Fri3dCamp/blaster_2024/Hardware/Fri3d_2024_Blaster_00/OUTPUT/BOM/Bill of Materials-Fri3d_2024_Blaster_00(Default).xls

Bill of Materials |  |  | Fri3D 2024 Blaster
Project: |  | Fri3d_2024_Blaster_00.PrjPcb
Revision: |  | 00
Variant: |  | Default
Creation Date: | 16/04/2024 | 21:35
Print Date: | 2024-04-28 | 21:45:25
Footprint | Comment | LibRef | Designator | Value | Description | Supplier 1 | Supplier Part Number 1 | Supplier 2 | Supplier Part Number 2 | Supplier 3 | Supplier Part Number 3 | Quantity
CUI_CEP-1162 | 14x14x7mm Piezo Buzzer Transducer 80dB | BUZ CUI CEP-1162 | BUZ1 | CMT-1203-SMT | BUZ CUI CEP-1162 | Digi-key | 102-1134-ND | LCSC | C360604 |  |  | 1
C_8x9_3.5mm |  | CAP 47µF 50V 8X9 | C1 | 47µF 50V | CAP 47µF 50V 8X9 | LCSC | C270004 |  |  |  | 47µF 50V 1% _8x9 | 1
C_5.08mm |  | CAP 100nF 50V 5.08mm | C2, C3, C4 | 100nF 50V | CAP 100nF 50V 5.08mm | LCSC | C84772 |  |  |  |  | 3
LED_5MM_RD | 5mm IR LED, 940nm, 100mA, 1.35V, 25Deg | LED IR 5mm TSAL6400 | D1 | TSAL6400 | LED IR 5mm TSAL6400 | Farnell | 3152868 | LCSC | C264290 |  |  | 1
VIS_TSOP381x_BENT | IRM-3638N3F14 Infrared Receiver 38 kHz 45° 2.7-5.5V | PHO IR Rx RA | D3, D4 | IRM-3638N3F14 | PHO IR Rx RA | LCSC | C264262 |  |  |  |  | 2
LED_8mm_RGB_RA | WS2812 based digital RGB LED 85mm | LED RGB WS2812 8mm | D5, D6, D7, D8 | WS2812D-F8 | LED RGB WS2812 8mm | LCSC | C139126 |  |  |  |  | 4
CUI_SJ1-3525NG | 3.5mm jack, dual switch, black, 3 contacts | AUDIO JACK 3.5 3c SJ1-3525NG | J1 | SJ1-3525NG | AUDIO JACK 3.5 3c SJ1-3525NG | Digi-key | CP1-3525NG-ND |  |  |  |  | 1
PHYX_LANA_TNY_SMD | CH23V203 based TNY module | MOD # CH23V203 LANA TNY SMD | MOD1 | LANA TNY | MOD # CH23V203 LANA TNY SMD | Phyx | LANA TNY |  |  |  |  | 1
HDR1X2 | Header 2 | Pin Header 2.54mm 2way | P1, P4 |  | Pin Header 2.54mm 2way | LCSC | C492401 | LCSC | C541856 |  |  | 2
HDR1X7 | Header 7 | Pin Header 2.54mm 7way | P2, P3 |  | Pin Header 2.54mm 7way |  |  |  |  |  |  | 2
RES_10mm |  | RES 33R 1/4W | R1 | 33R | RES 33R 1/4W | LCSC | C173006 |  |  | Generic | 33R 1/4W 1% TH 10mm | 1
RES_10mm |  | RES 120R 1/4W | R2 | 120R | RES 120R 1/4W | LCSC | C58684 |  |  | Generic | 120R 1/4W 1% TH 10mm | 1
TACTSW_RA_385 | Tact switch, RA, 3,85mm | SW TACT RA 3,85mm 431256038716 | SW1 | 431256038716 | SW TACT RA 3,85mm 431256038716 | Wurth | 431256038716 | Mouser | 710-431256038716 |  |  | 1
SK13D07VG3 | 1P3T SK13D07VG3 3mm post | SW Slide SP3T SK13D07VG3 | SW2 | SK13D07VG3 | SW Slide SP3T SK13D07VG3 | LCSC | C2681580 |  |  |  |  | 1
TO-92A_WIDE | 0.2A 40V 100hfe NPN Transistor | 2N3904 NPN 0.2A | T1 | 2N3904 | 2N3904 NPN 0.2A | Farnell | 1700648 | LCSC | C118538 |  |  | 1
 |  |  |  |  |  |  |  |  |  |  |  | 23
Approved |  | Notes
