Fri3dCamp/blaster_2024/(threads)

Thread 1 (2024-05-02):

Replace current "CRC" by a real CRC8 implementation.

melazarus, 2024-05-02:
current CRC function is not a true CRC8.

Closed 2024-07-23.
