Fri3dCamp/blaster_2024/Hardware/Fri3d_2024_Blaster_01/OUTPUT/Fri3d_2024_Blaster_01.PDF

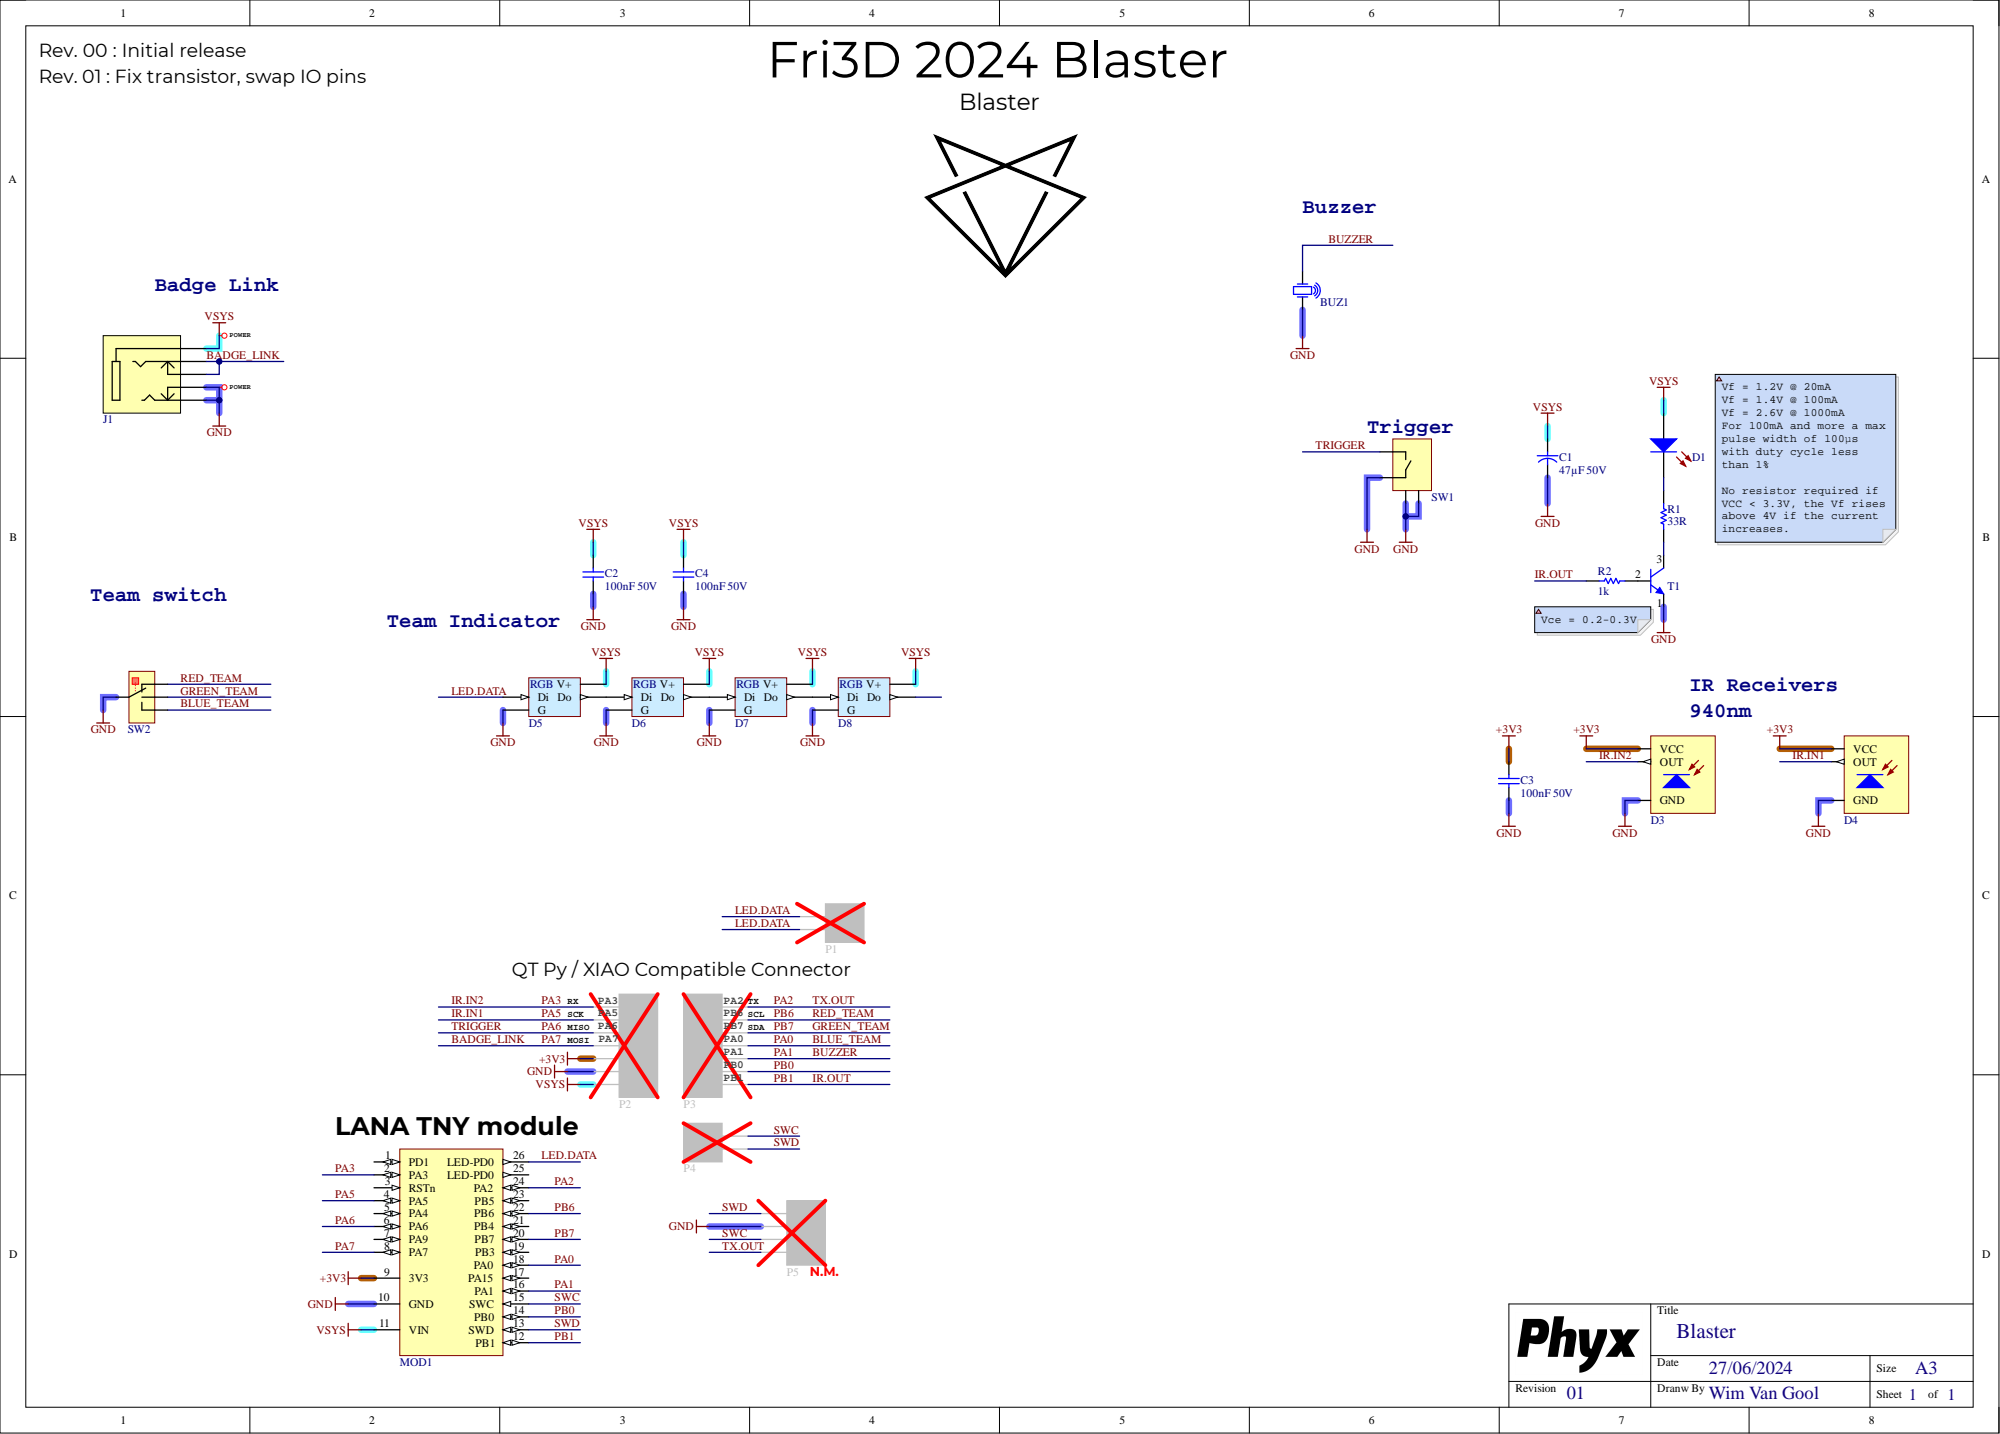
[picture p2: page 1]

Fri3D 2024 Blaster Rev. 00 : Initial release
Rev. 01 : Fix transis

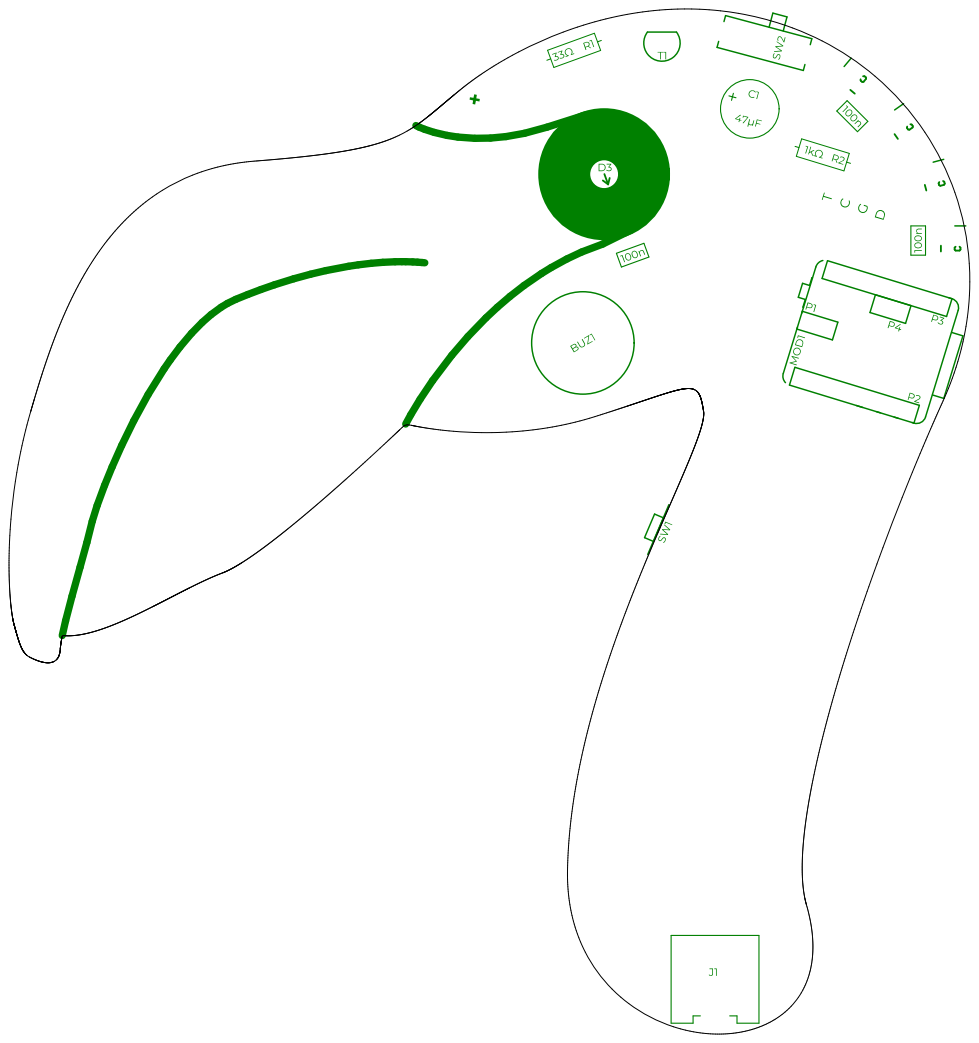
[picture p3: page 2]

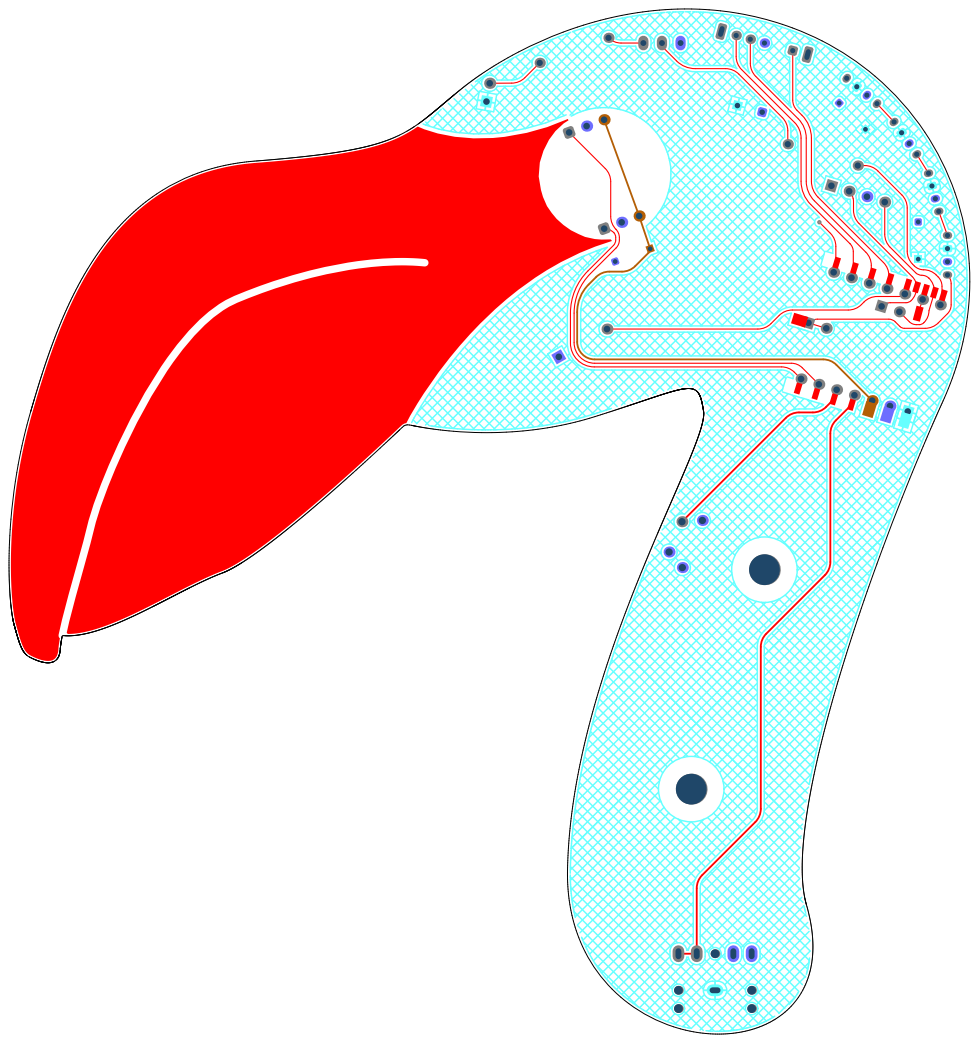
[picture p4: page 3]

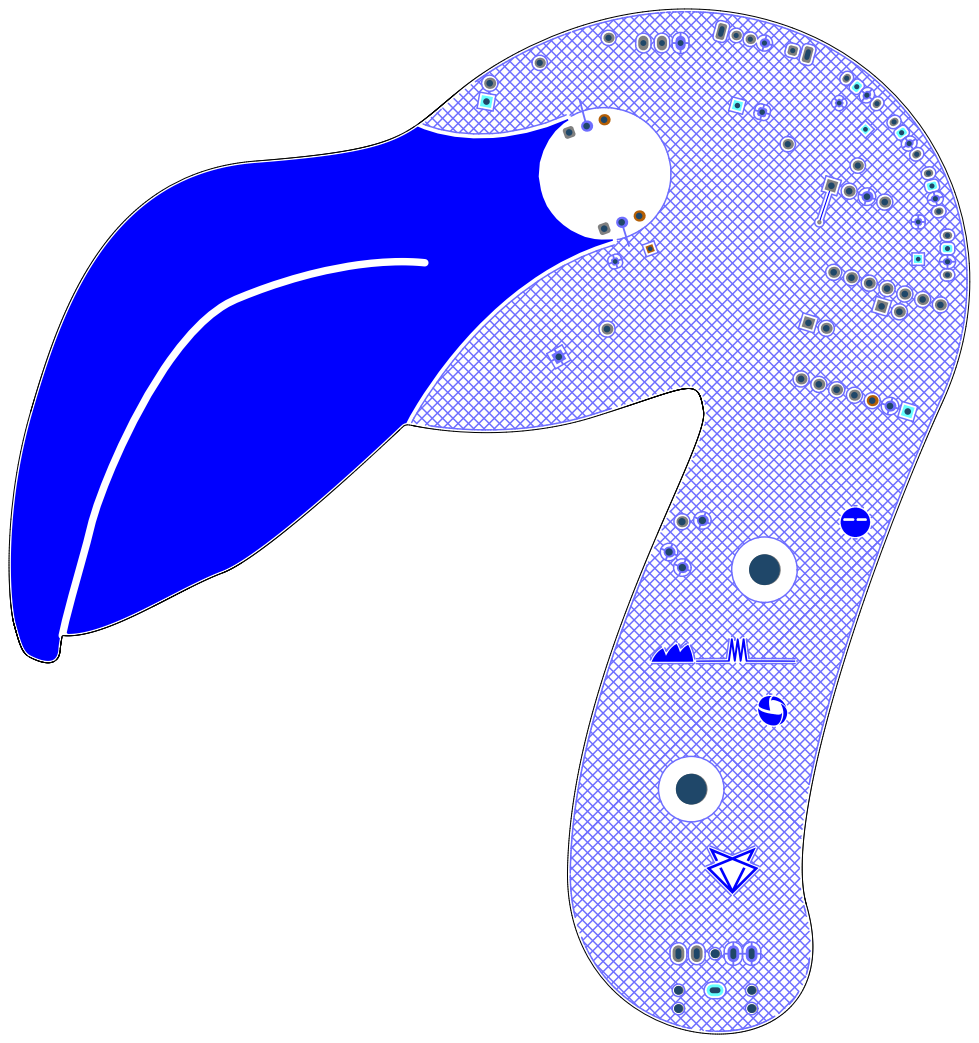
[picture p5: page 4]

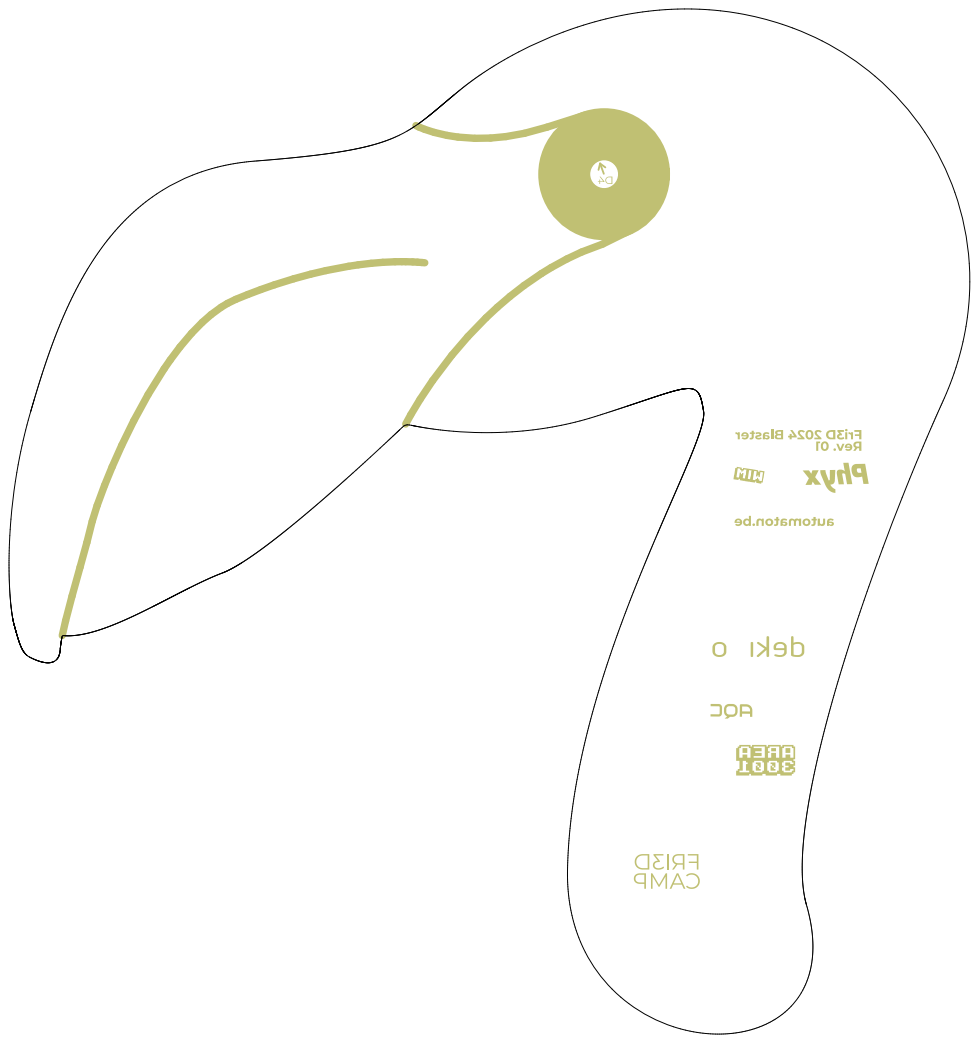
[picture p6: page 5]

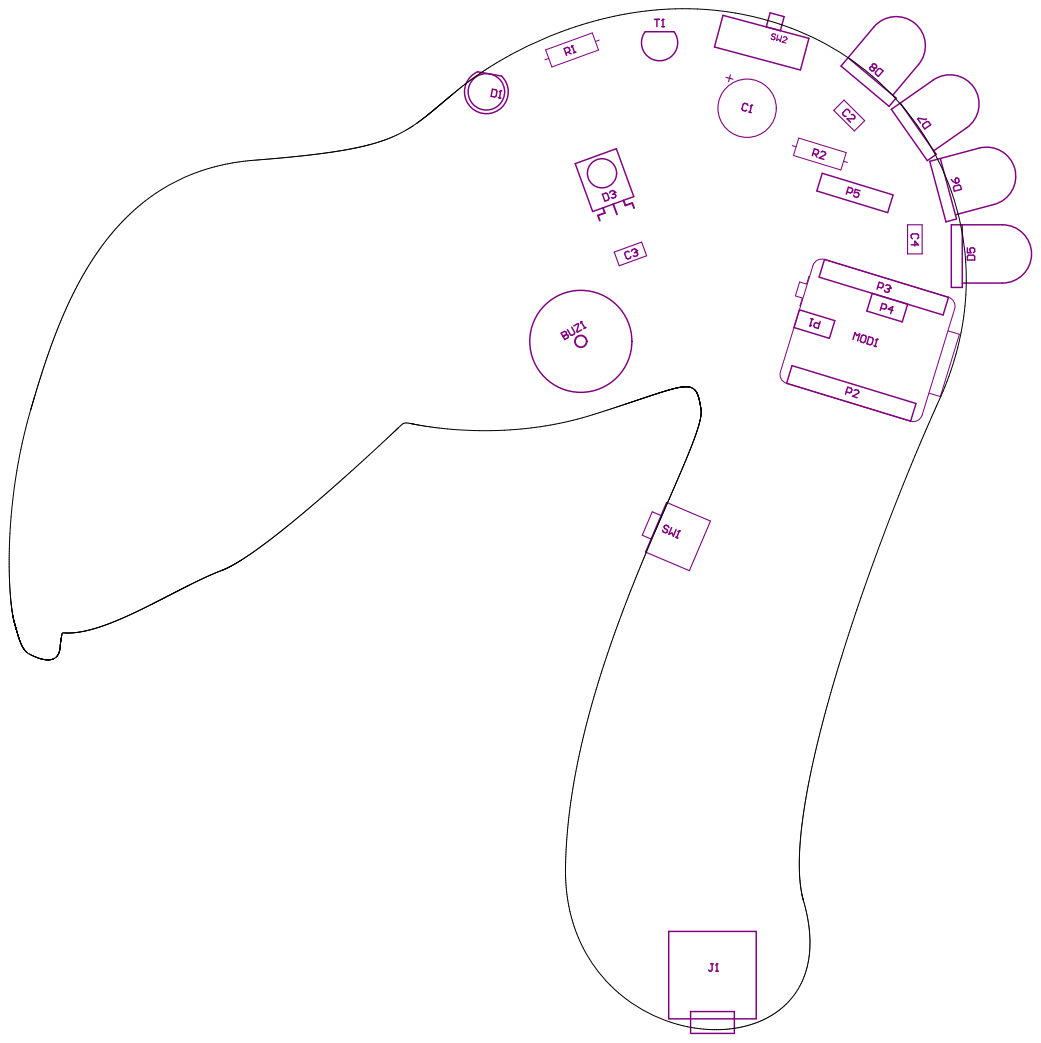
[picture p7: page 6]

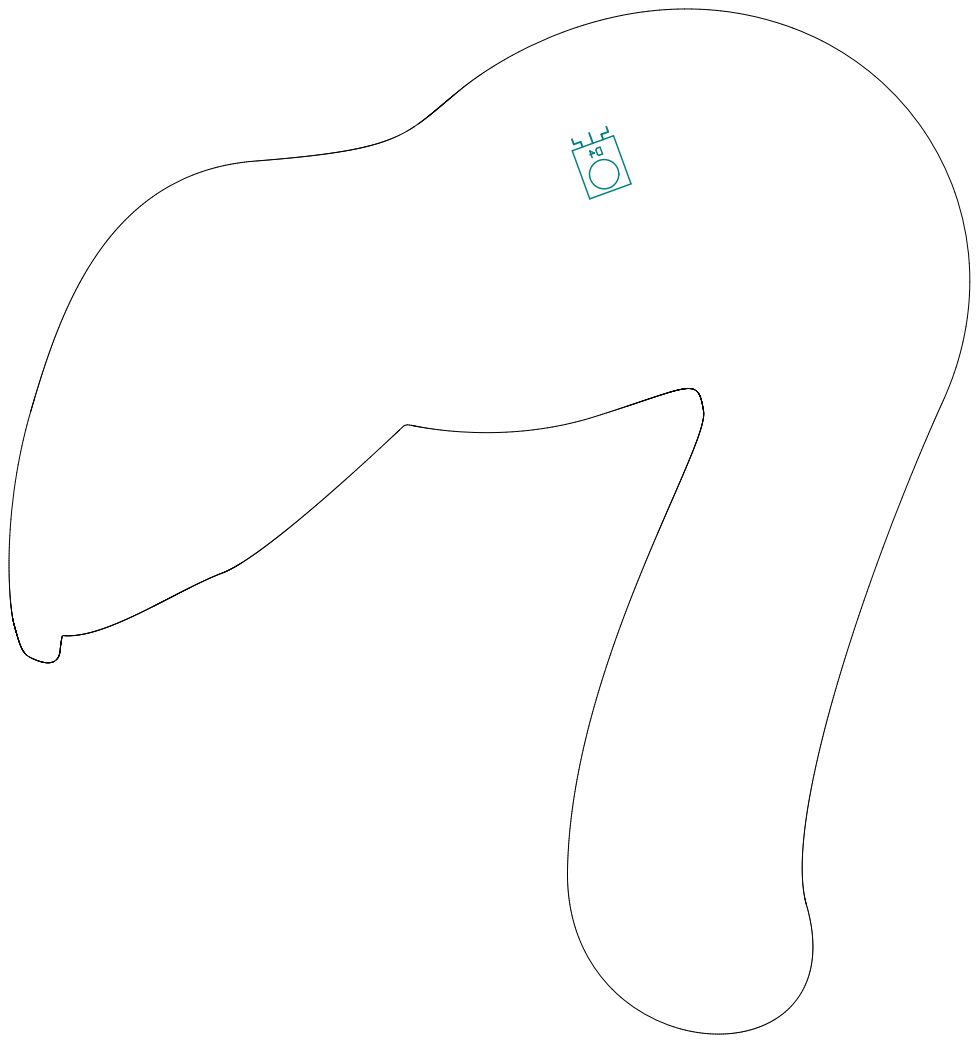
[picture p8: page 7]

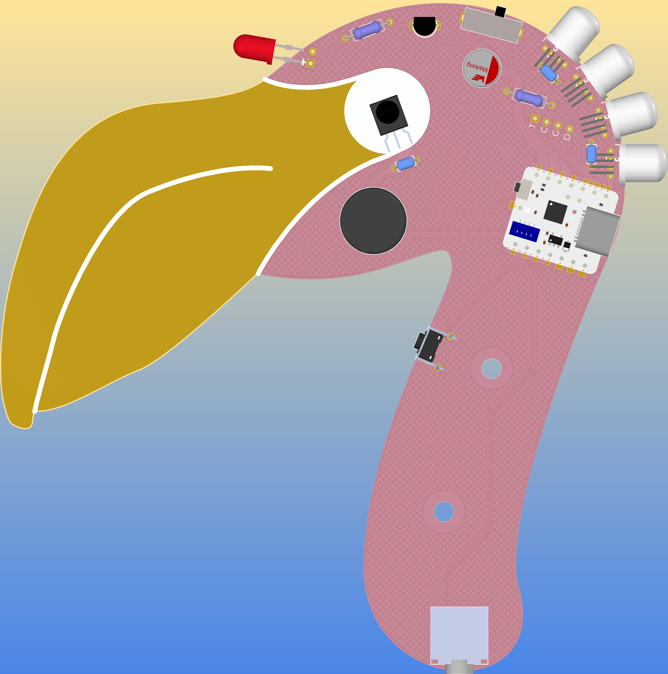
[picture p9: page 8]

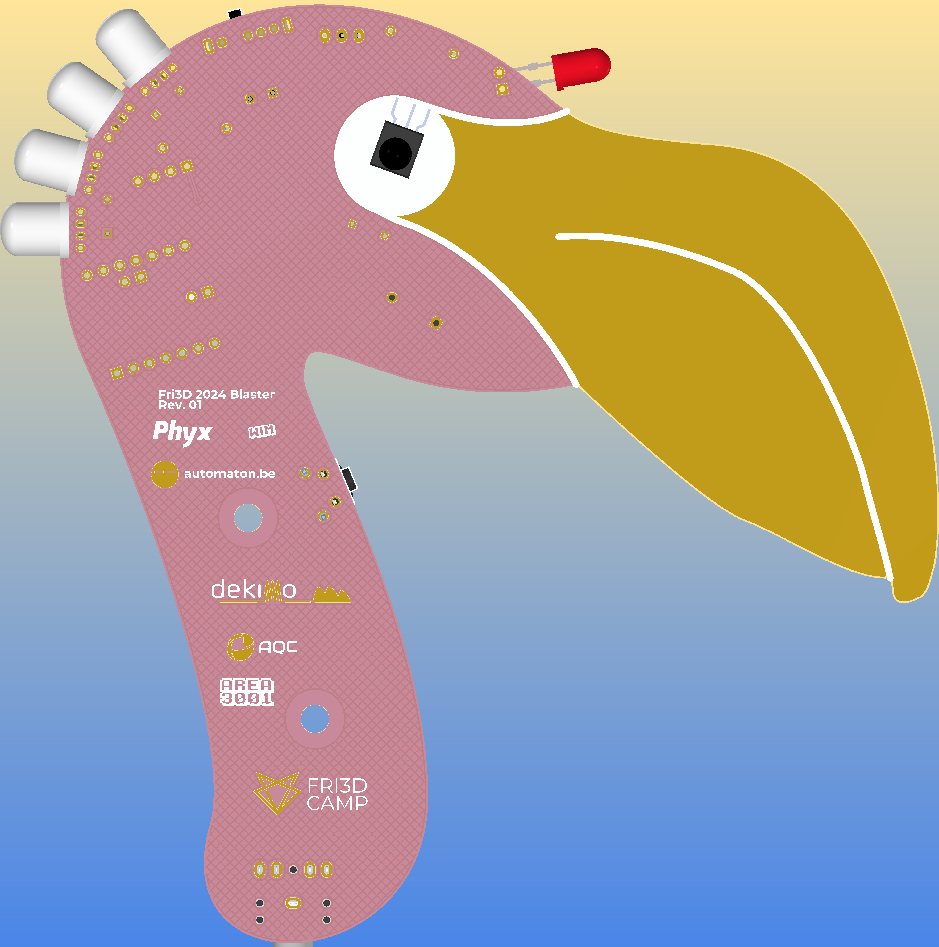
[picture p10: page 9]
