Fri3dCamp/blaster_2024/Hardware/Fri3d_2024_Blaster_00/OUTPUT/Fri3d_2024_Blaster_00.PDF

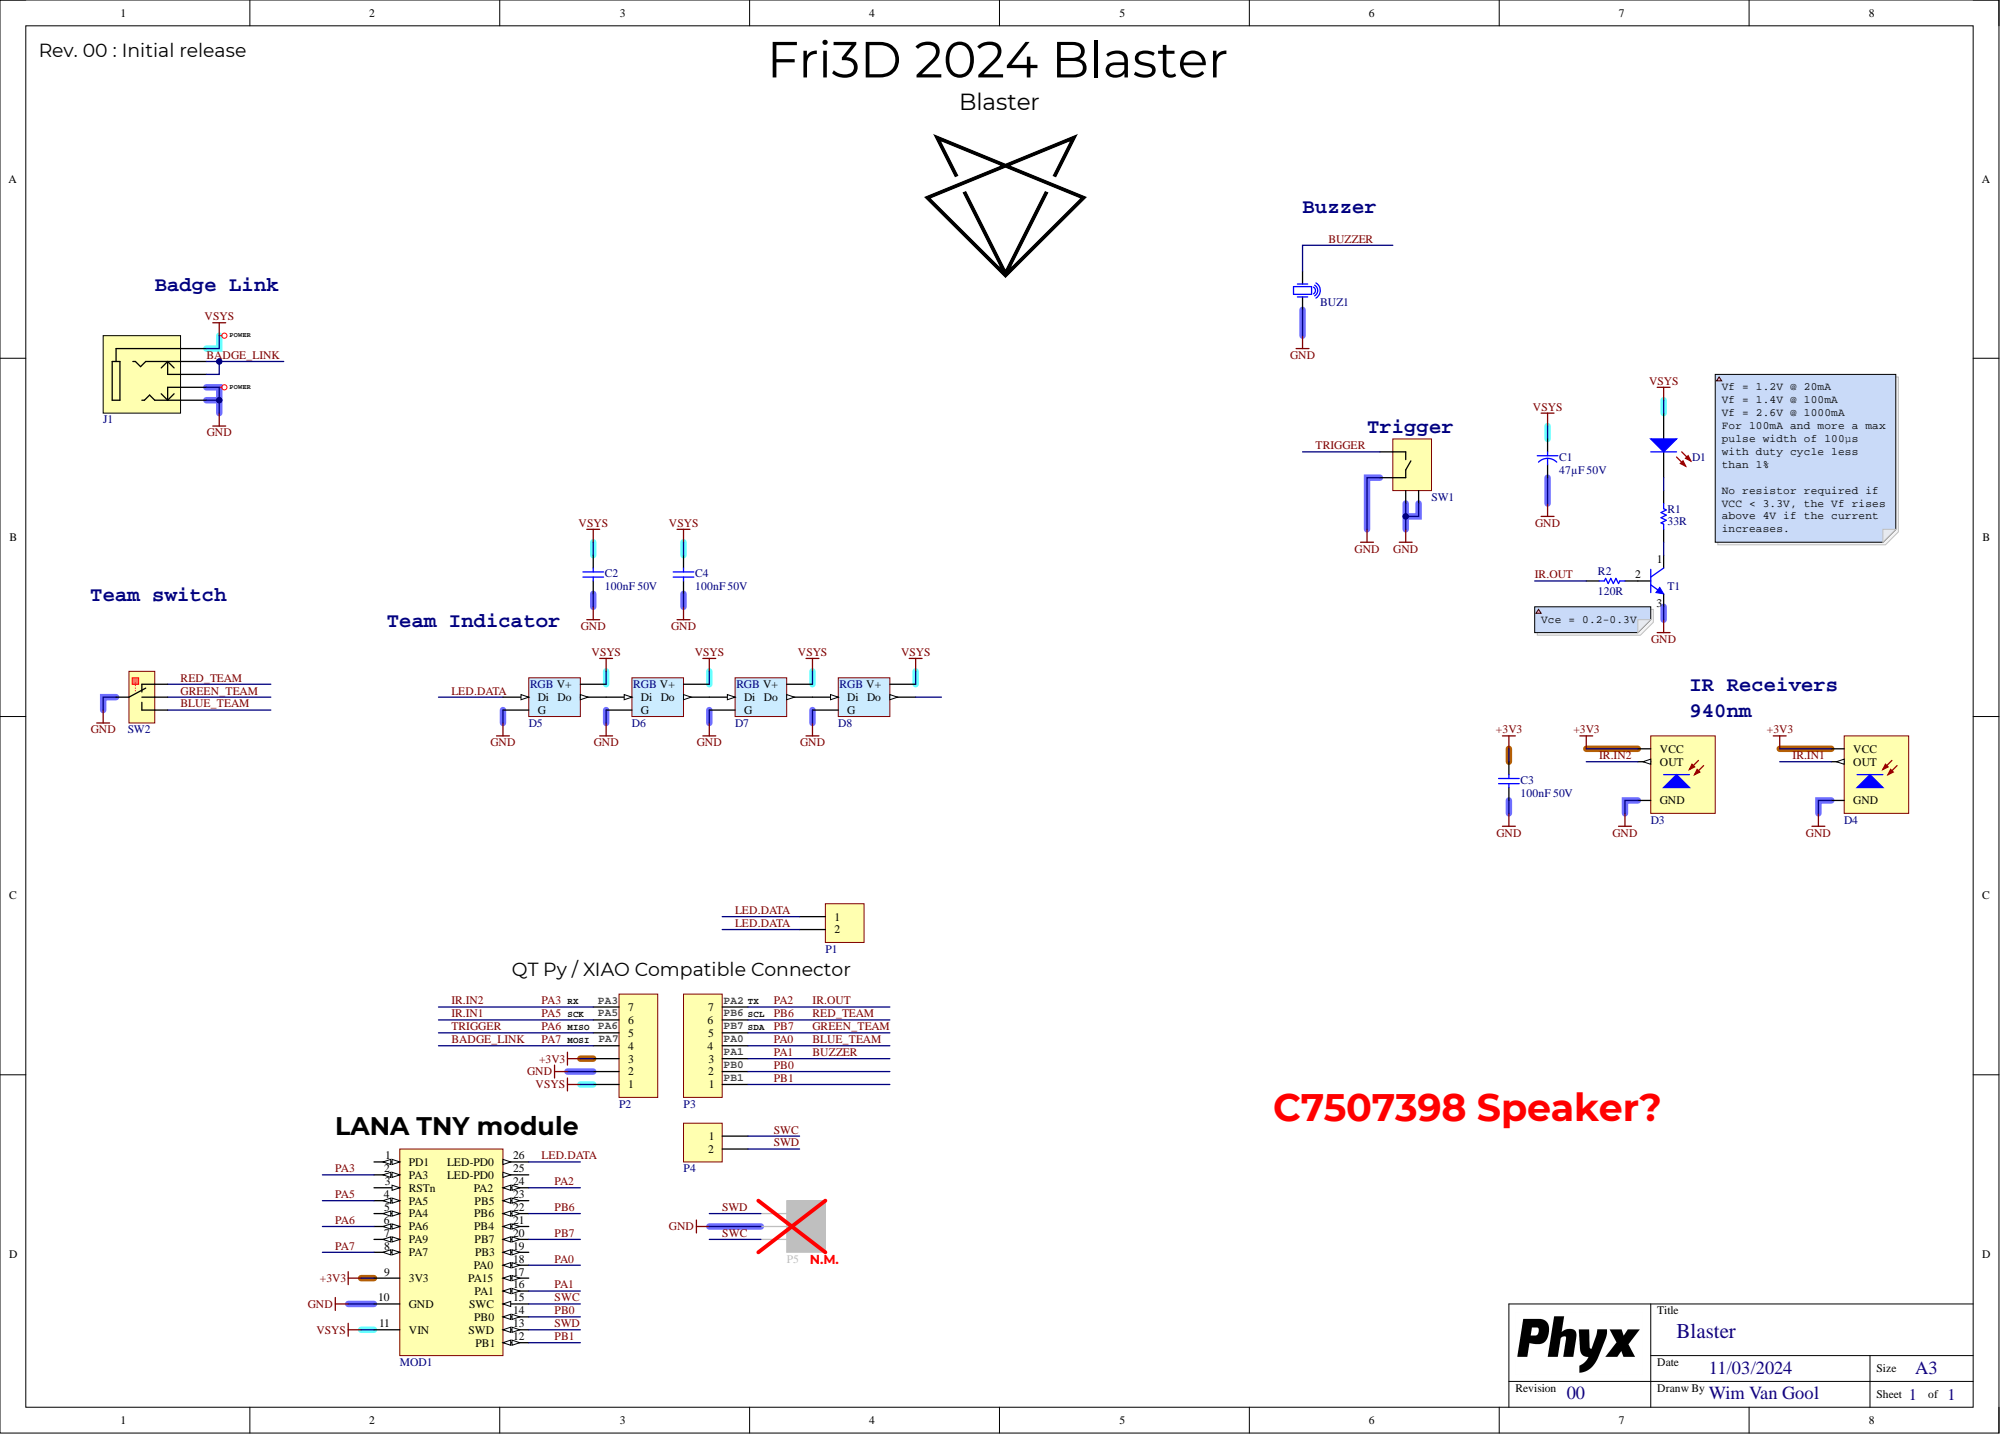
[picture p11: page 1]

Fri3D 2024 Blaster Rev. 00 : Initial release

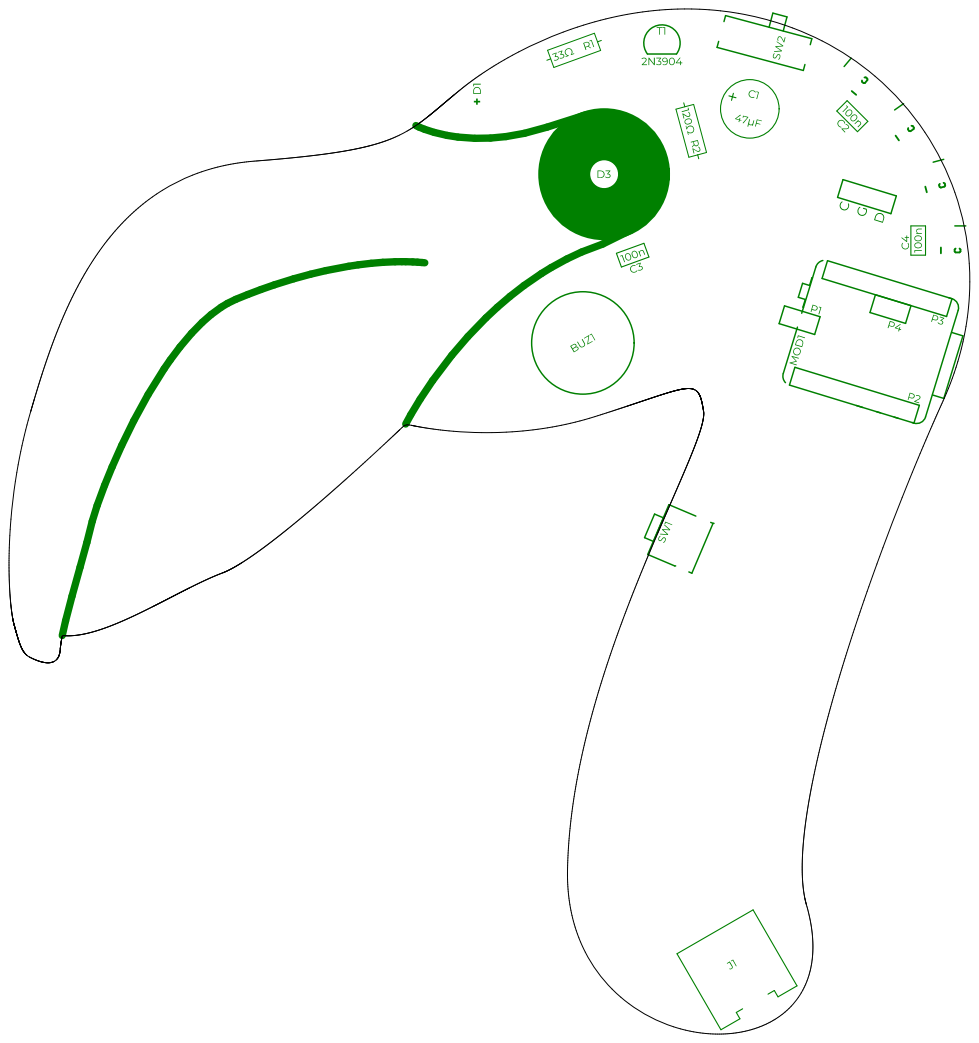
[picture p12: page 2]

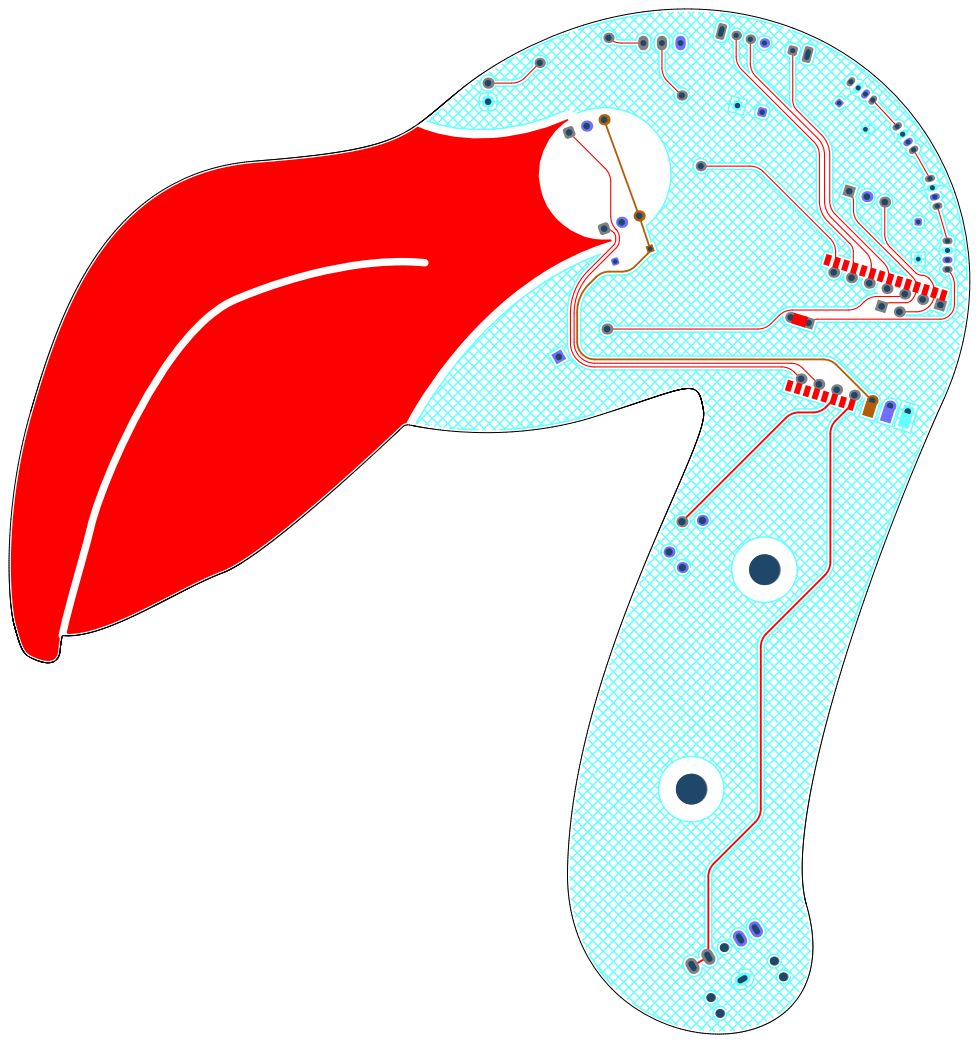
[picture p13: page 3]

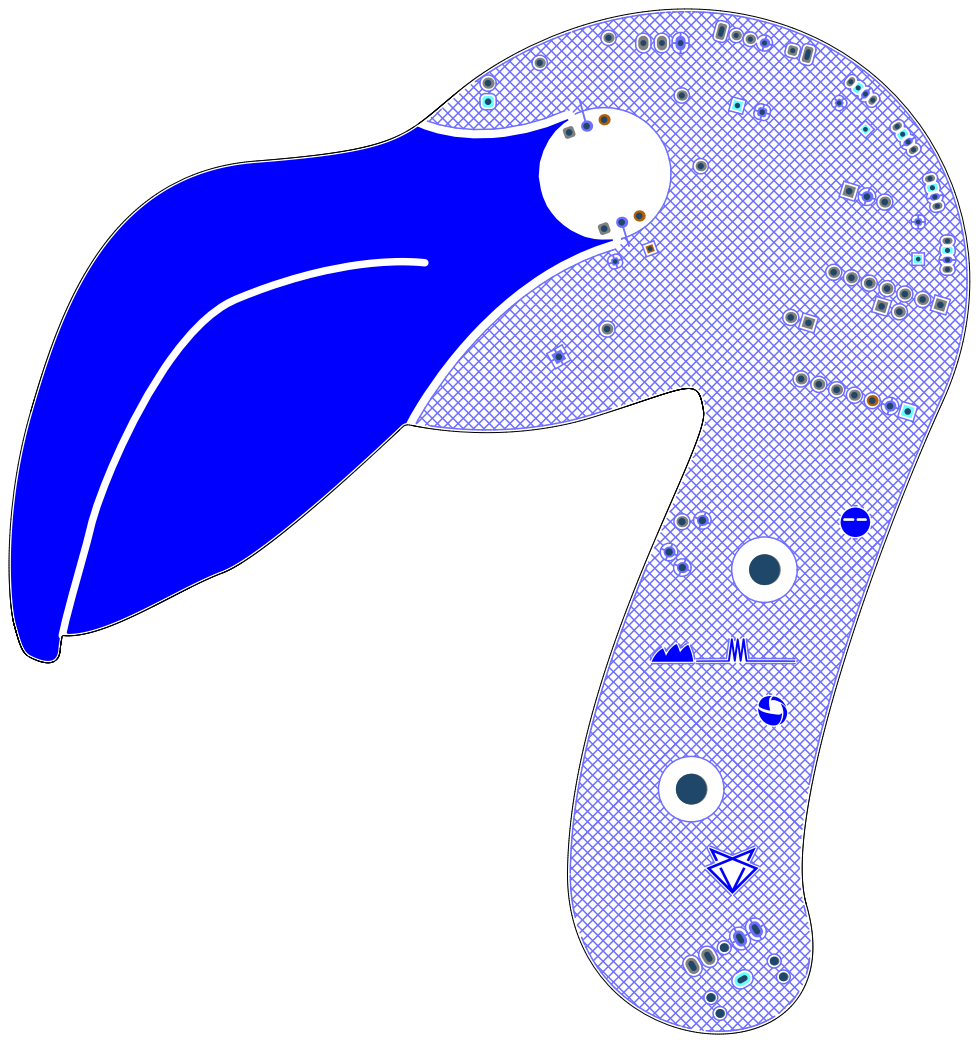
[picture p14: page 4]

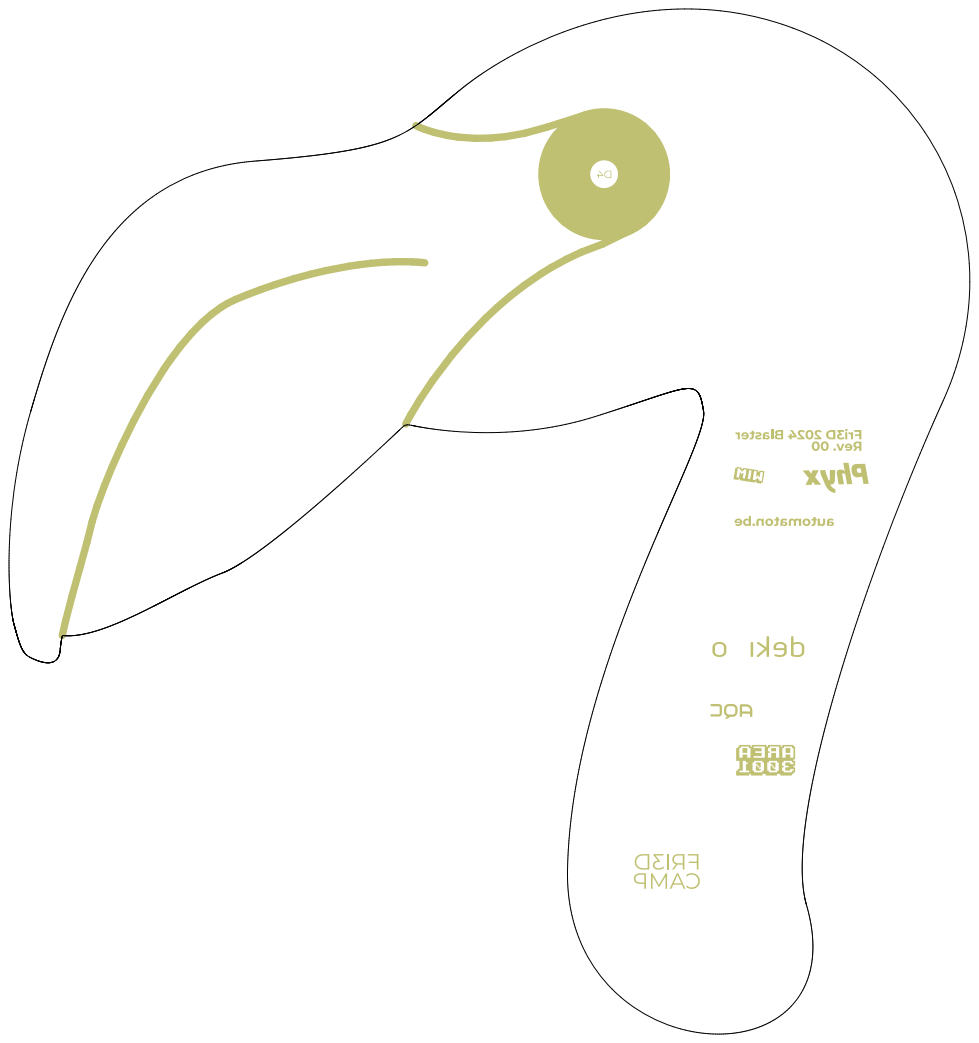
[picture p15: page 5]

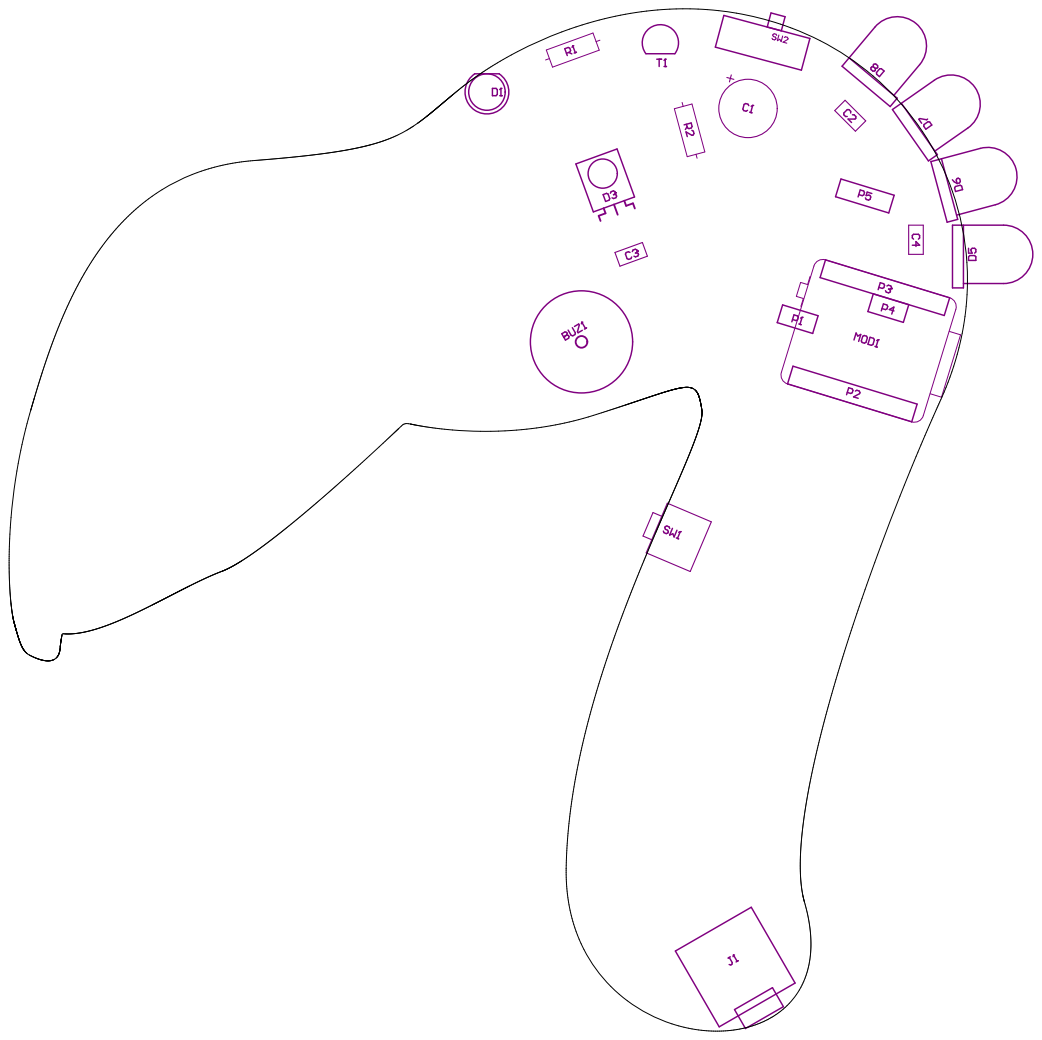
[picture p16: page 6]


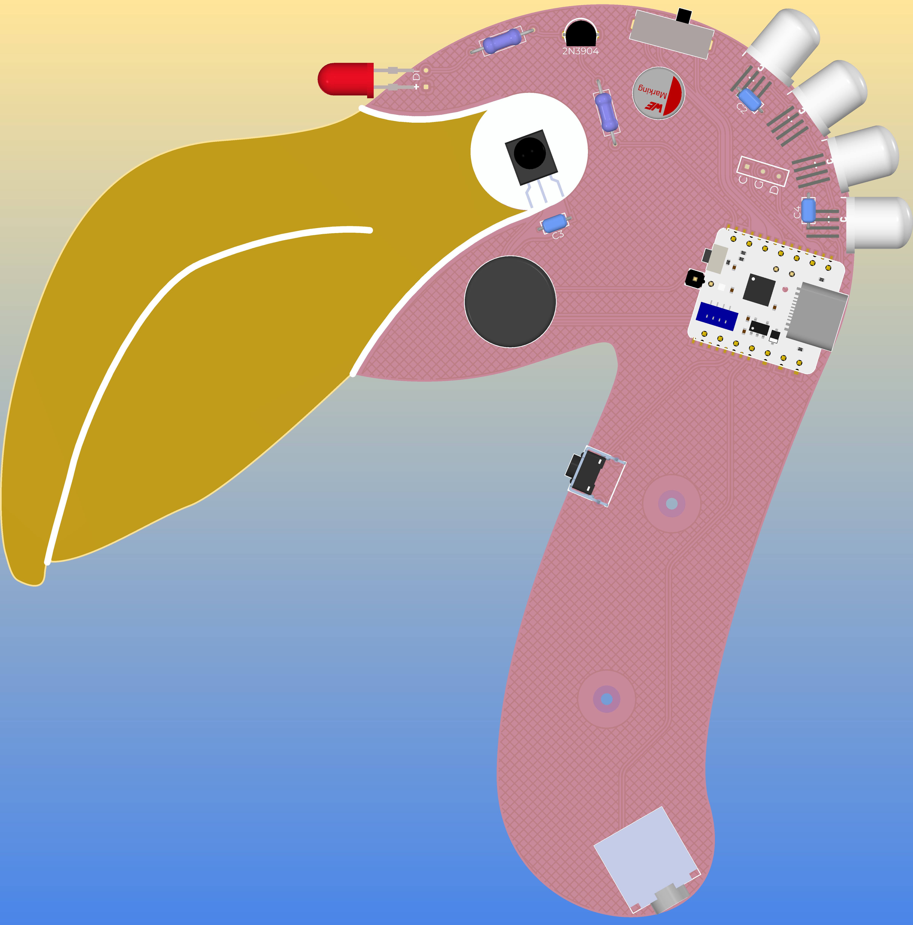
[picture p17: page 8]

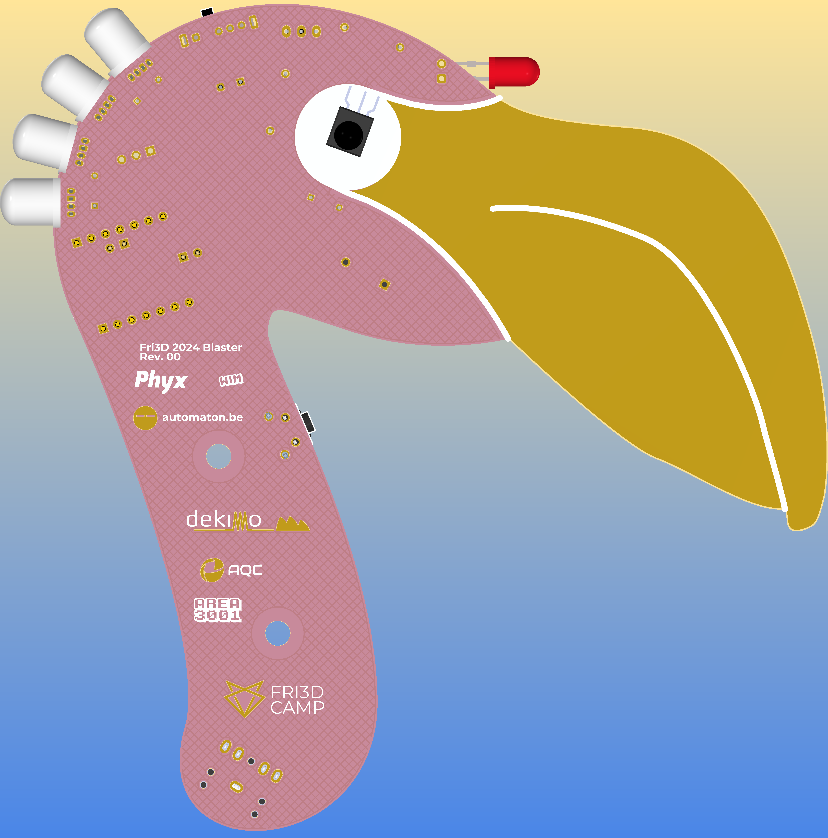
[picture p18: page 9]
