Fri3dCamp/blaster_2024/(list of files, drawings)

Other design files:
Hardware/Fri3d_2024_Blaster_00/Fri3d_2024_Blaster_00.PrjPcb
Hardware/Fri3d_2024_Blaster_00/Fri3d_2024_Blaster_00.SchDoc
Hardware/Fri3d_2024_Blaster_01/Fri3d_2024_Blaster_01.PrjPcb
Hardware/Fri3d_2024_Blaster_01/Fri3d_2024_Blaster_01.SchDoc
