Fri3dCamp/blaster_2024/Sources/2024_blaster/src/lana.h

#ifndef LANA_H
#define LANA_H

#include <debug.h>

#define PIN_PA0  0
#define PIN_PA1  1
#define PIN_PA2  2
#define PIN_PA3  3
#define PIN_PA4  4
#define PIN_PA5  5
#define PIN_PA6  6
#define PIN_PA7  7
#define PIN_PA9  9
#define PIN_PA13 13
#define PIN_PA14 14
#define PIN_PA15 15

#define PIN_PB0 16 + 0
#define PIN_PB1 16 + 1
#define PIN_PB3 16 + 3
#define PIN_PB4 16 + 4
#define PIN_PB5 16 + 5
#define PIN_PB6 16 + 6
#define PIN_PB7 16 + 7
#define PIN_PB8 16 + 8

#define PIN_PD0 48 + 0
#define PIN_PD1 48 + 1

#define HIGH 0x1
#define LOW  0x0

#define INPUT          0x0
#define OUTPUT         0x1
#define INPUT_PULLUP   0x2
#define INPUT_PULLDOWN 0x3
#define OUTPUT_AF_PP   0x4

extern volatile int triggered;

uint64_t micros(void);
uint64_t millis(void);
void delay_micros(uint32_t delay);
void delay_ms(uint32_t delay);
void SYSTICK_Init_Config(u64 ticks);

// void LED_SendBit(uint8_t bit);
// void LED_SendColour(uint8_t red, uint8_t green, uint8_t blue);
// void SetLed(int i, uint8_t r,uint8_t g,uint8_t b);
// void Write(void);
GPIO_TypeDef *PinToPort(int pin);
uint32_t PinToPeriph(int pin);
uint16_t PinToBitMask(int pin);
void DisableSWD_UsePinsAsGPIO(void);
void EnableSWD_UsePinsAsGPIO(void);
void pinMode(uint8_t pin, uint8_t mode);
void digitalWrite(uint8_t pin, int value);
uint8_t digitalRead(uint8_t pin);
// void initNeopixel(void);

enum Note
{
    DO = 3270,
    DO_S = 3465,
    C = 3270,
    C_S = 3465,

    RE = 3671,
    RE_S = 3889,
    D = 3671,
    D_S = 3889,

    MI = 4120,
    E = 4120,

    FA = 4365,
    FA_S = 4625,
    F = 4365,
    F_S = 4625,

    SOL = 4900,
    SOL_S = 5191,
    G = 4900,
    G_S = 5191,

    LA = 5500,
    LA_S = 5827,
    A = 5500,
    A_S = 5827,

    SI = 6174,
    B = 6174
};
void change_tone(uint16_t frequency);
void tone(uint16_t frequency);
void notone(void);

#endif
