Fri3dCamp/blaster_2024/Sources/2024_blaster/src/leds.h

#ifndef LEDS_H
#define LEDS_H

/* TODO
 * clean up code and naming
 * rainbow(index) > color
 * */

void init_leds();
uint32_t color(int r, int g, int b);
void set_led(int led, uint32_t color);
void fill(uint32_t color);
void write_leds(void);

#endif
