Fri3dCamp/blaster_2024/(commit log)

2024-04-28 Initial commit of HW
    initial commit of design files for REV.00
    [Bill of Materials-Fri3d_2024_Blaster_00(Default).xls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]
2024-07-08 cleanup led code
2024-07-09 Moved HW design, added REV01
    Moved the REV00 HW design to the Hardware folder, added REV01 design as well
    [Bill of Materials-Fri3d_2024_Blaster_00(Default).xls, Bill of Materials-Fri3d_2024_Blaster_01(Default).xls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]
2024-07-09 picture added
    added an image of the prototype blaster
2024-07-10 UART1 -> UART2
2024-07-13 Timer adjust TIM1
2024-07-14 porting led library
2024-07-14 add systick timer
2024-07-14 100 µs Systick interrupt
2024-07-15 removed old timer1 code
2024-07-15 millis and micros
2024-07-15 IR Interrupts
2024-07-20 fixed delay function halting after ~70minutes
    [lana.c]
2024-07-20 Read trigger switch
2024-07-22 some animations and fixed fast sweeps for the buzzer
    [lana.c, lana.h, main.c]
2024-08-08 replace union punning with C++ class with bitshifts
    [Firmware.ino, data.cpp, data.h]
2024-08-08 fix for empty packet (ex: in case of wrong crc)
    [main.c]
2024-08-12 Revert "listen for start pulse + adapt state machine"
    [data.c, data.h]
